Davoskio/8-bit-computer/Computer_PCB.png

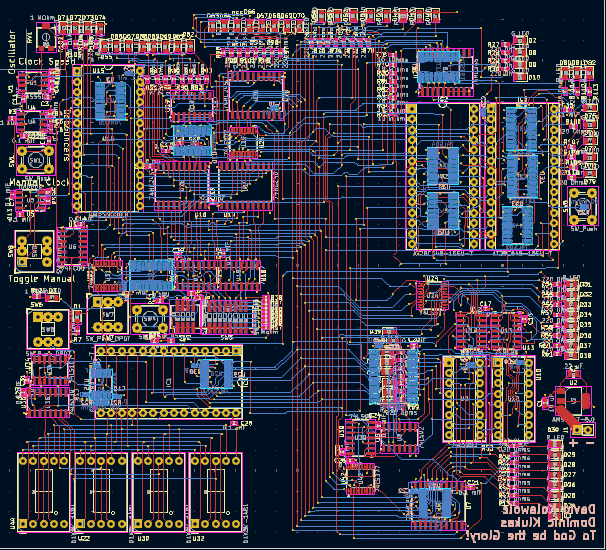
Computer_PCB.png
