Davoskio/8-bit-computer/Computer_schematic.png

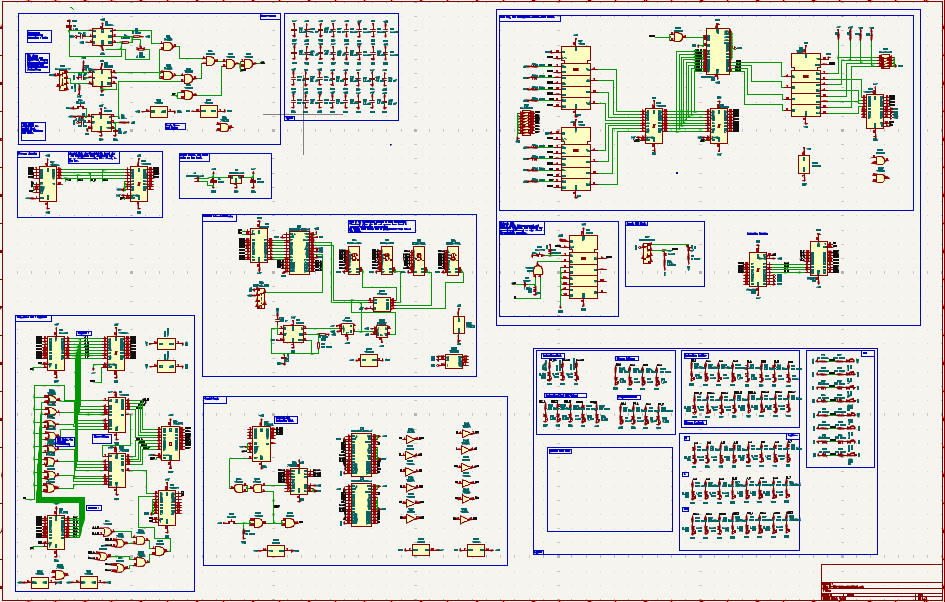
Computer_schematic.png
