Davoskio/8-bit-computer/8-Bit-Computer/8-Bit-Computer.kicad_pcb

## KiCad design 8-Bit-Computer/8-Bit-Computer.kicad_pcb (2024-05-07)

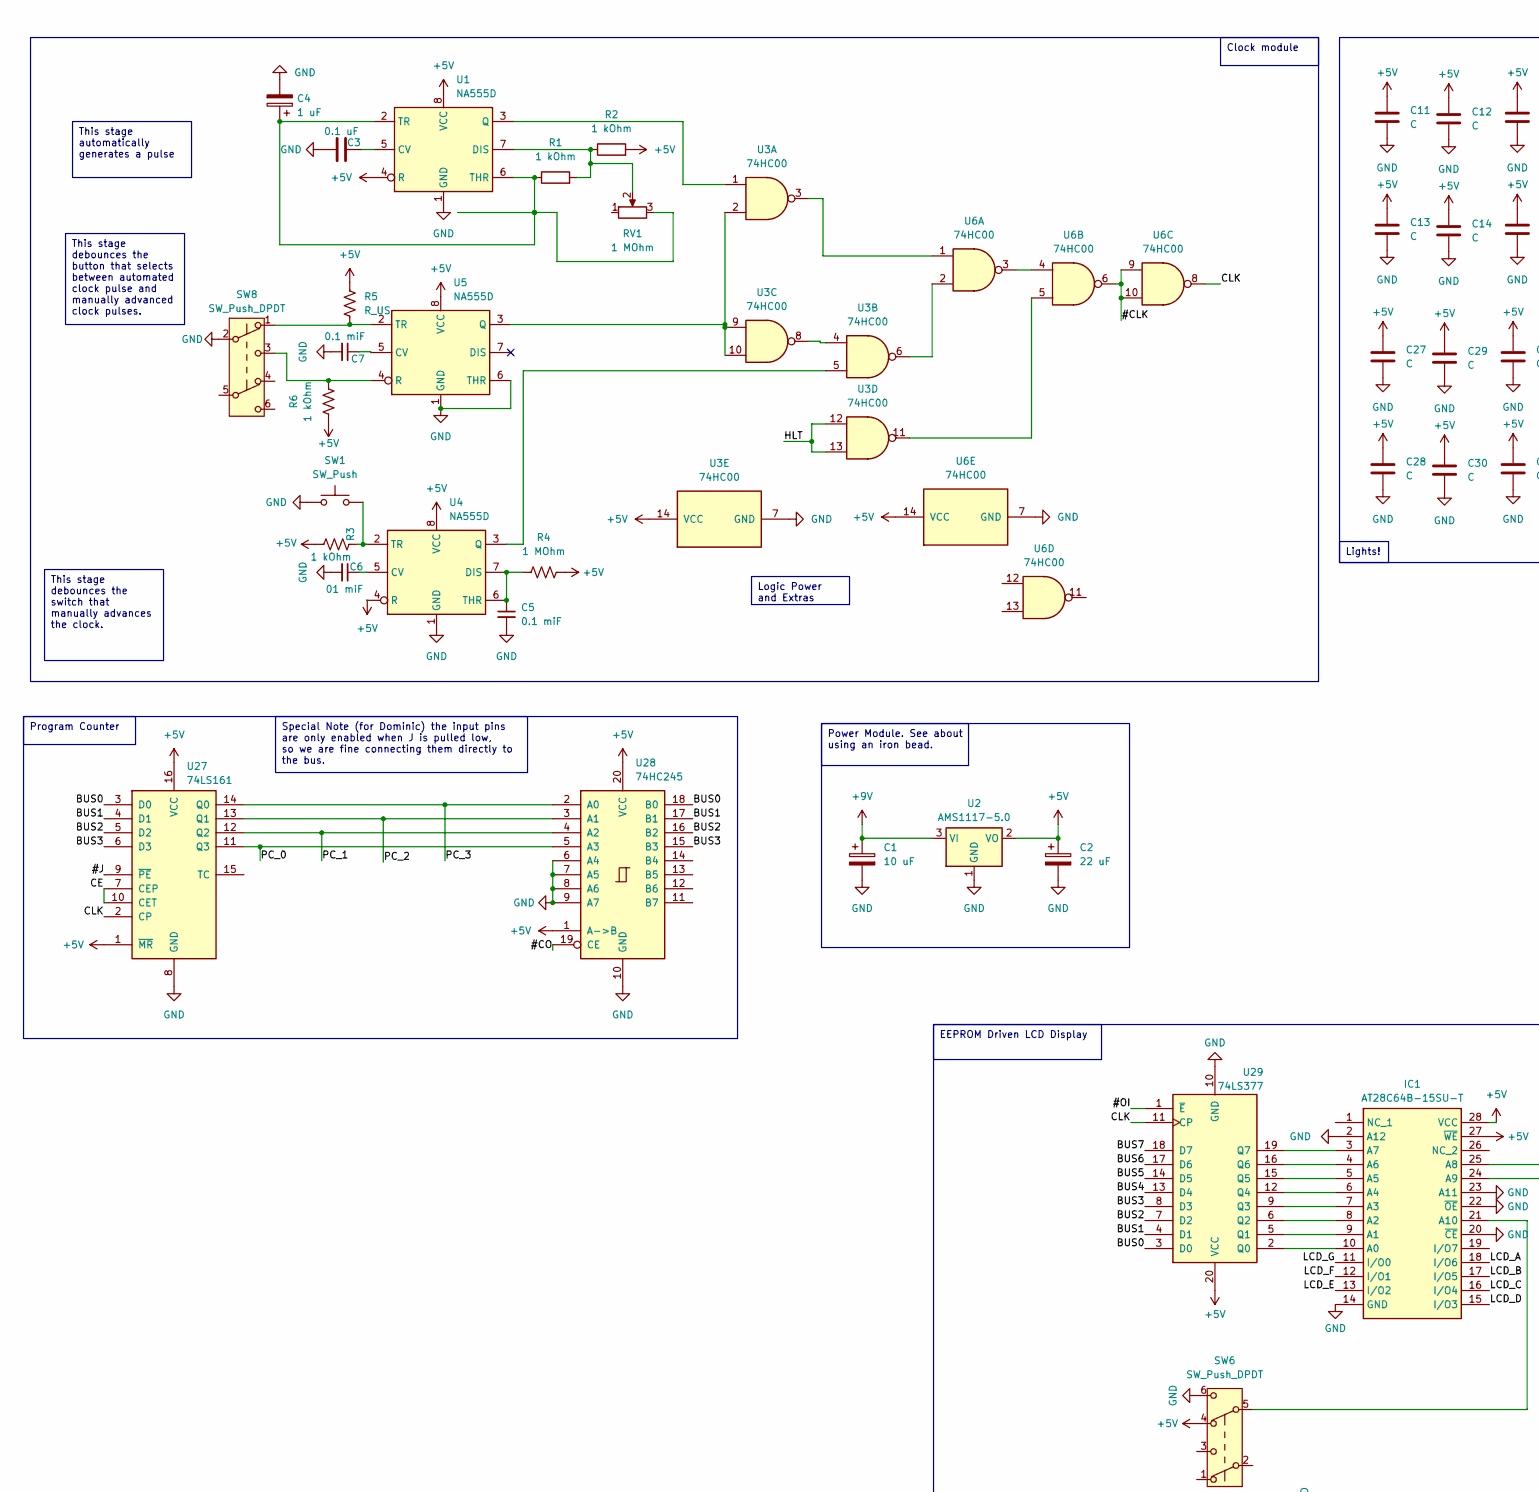
[picture p3: schematic 8-Bit-Computer.kicad_sch, part in row 1, column 1]

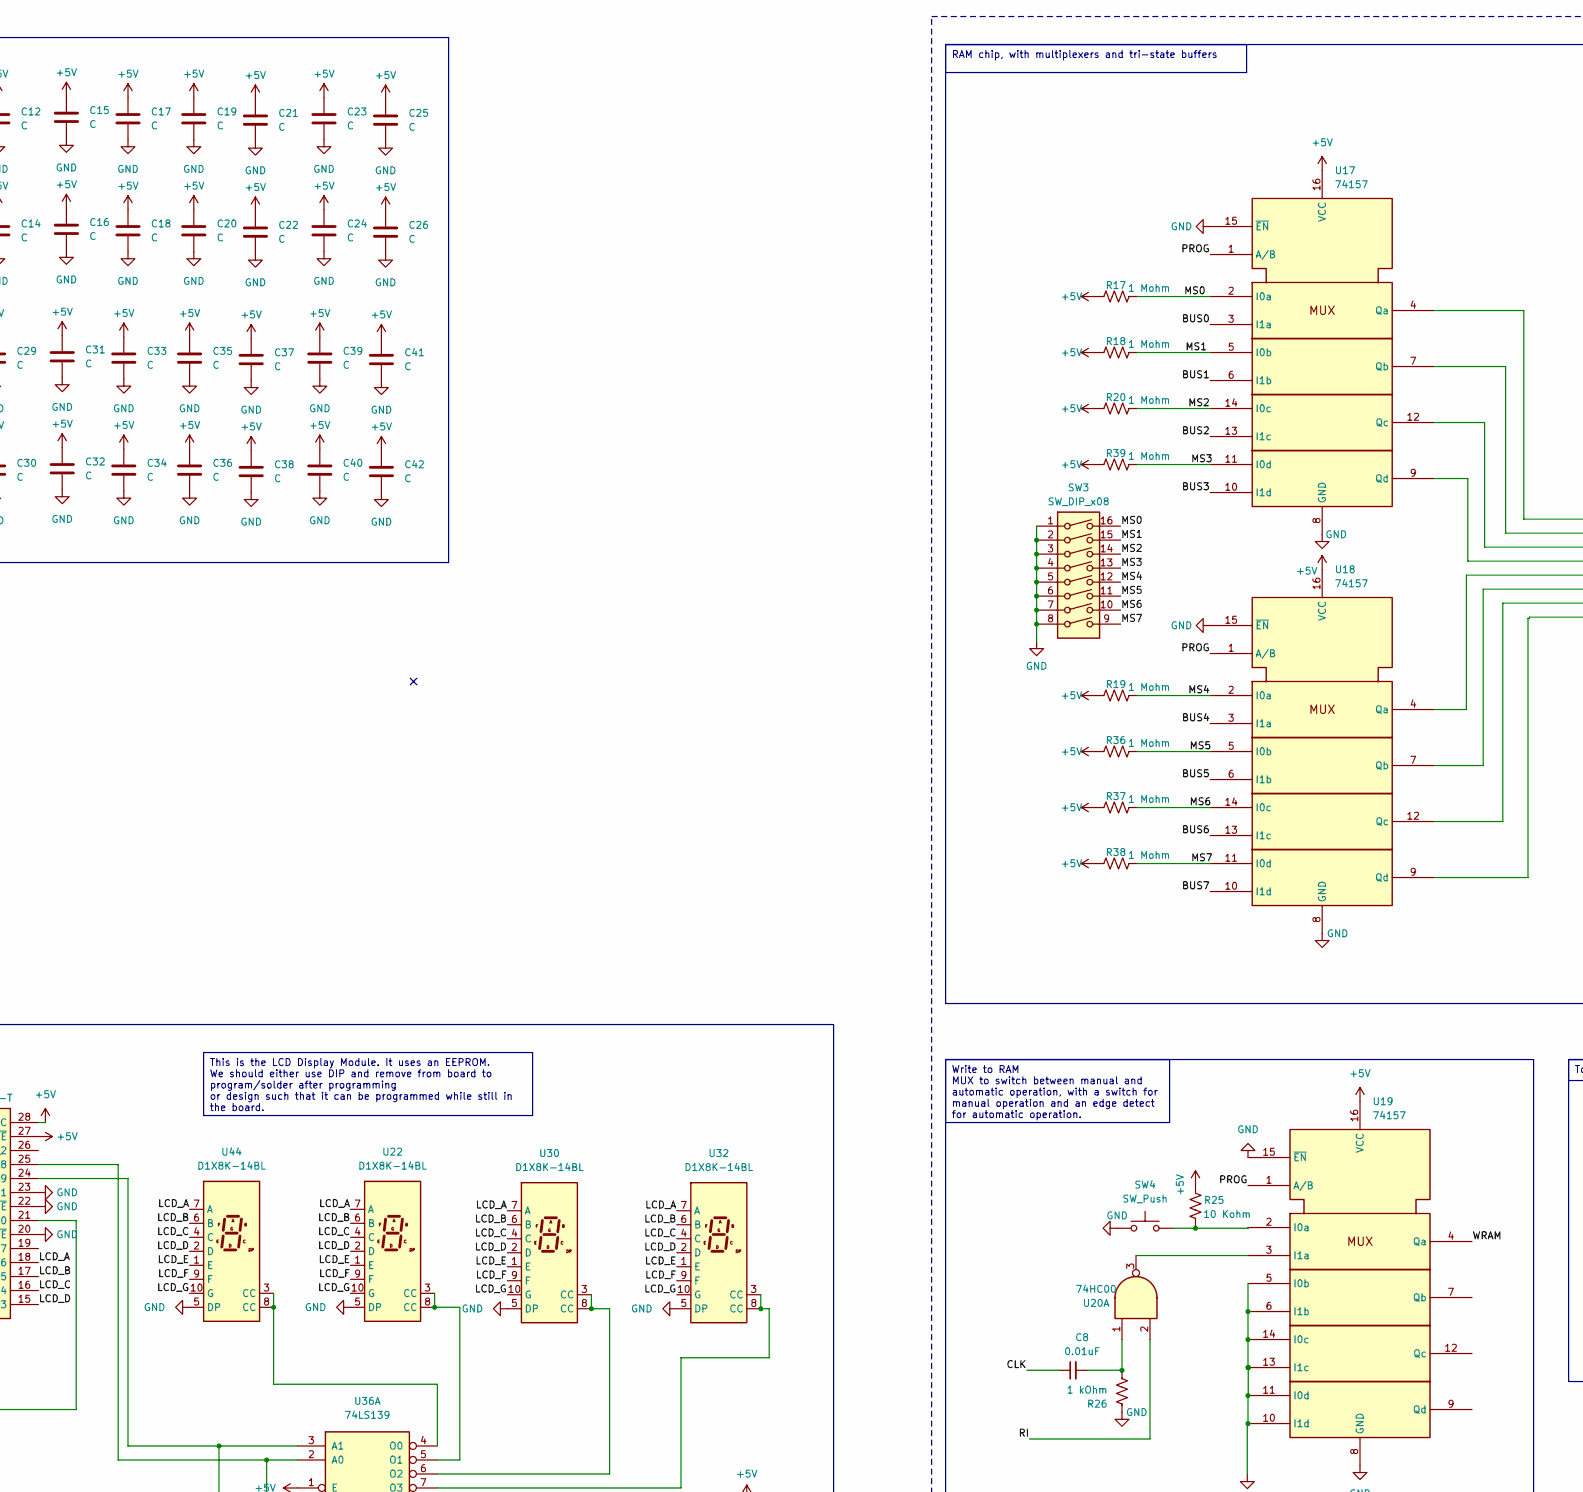
[picture p4: schematic 8-Bit-Computer.kicad_sch, part in row 1, column 2]

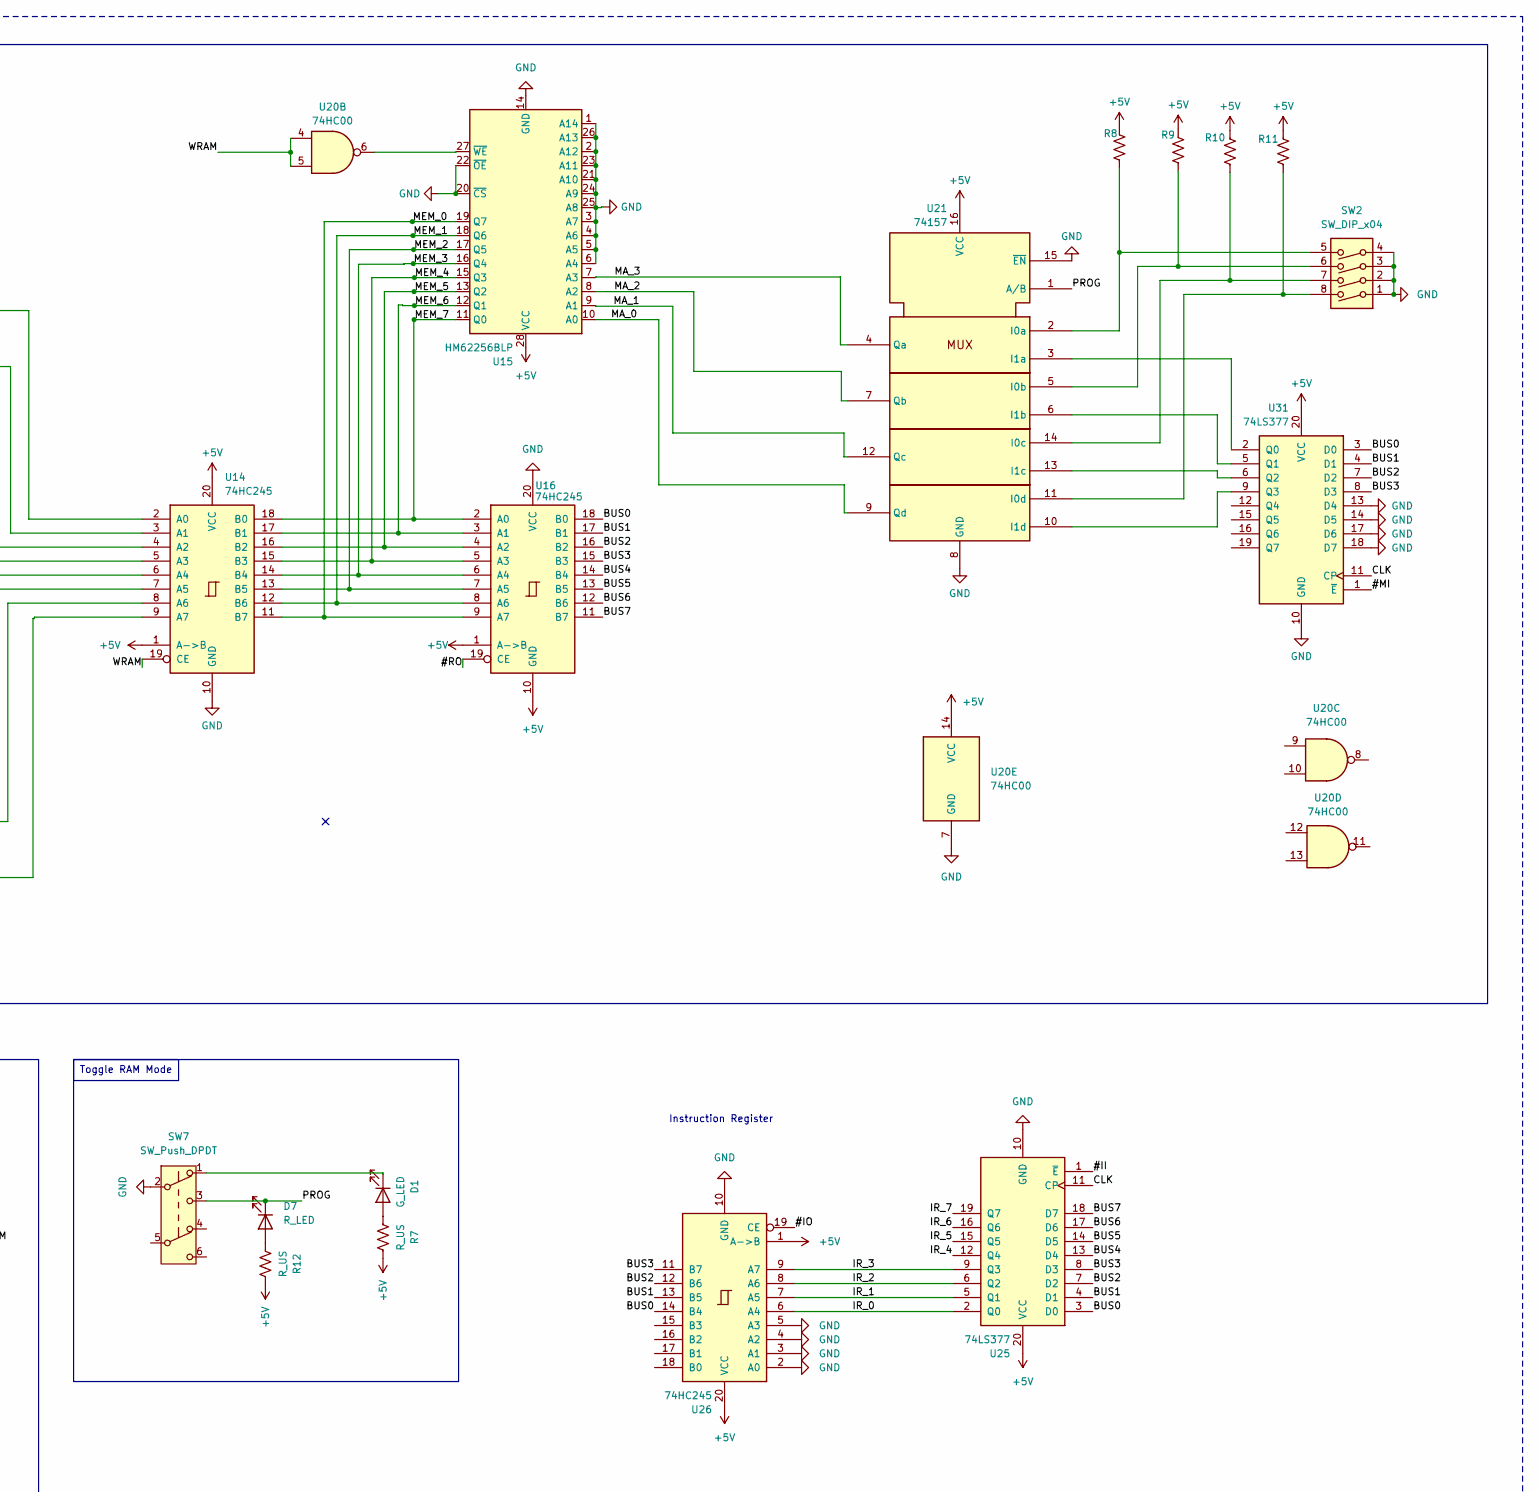
[picture p5: schematic 8-Bit-Computer.kicad_sch, part in row 1, column 3]

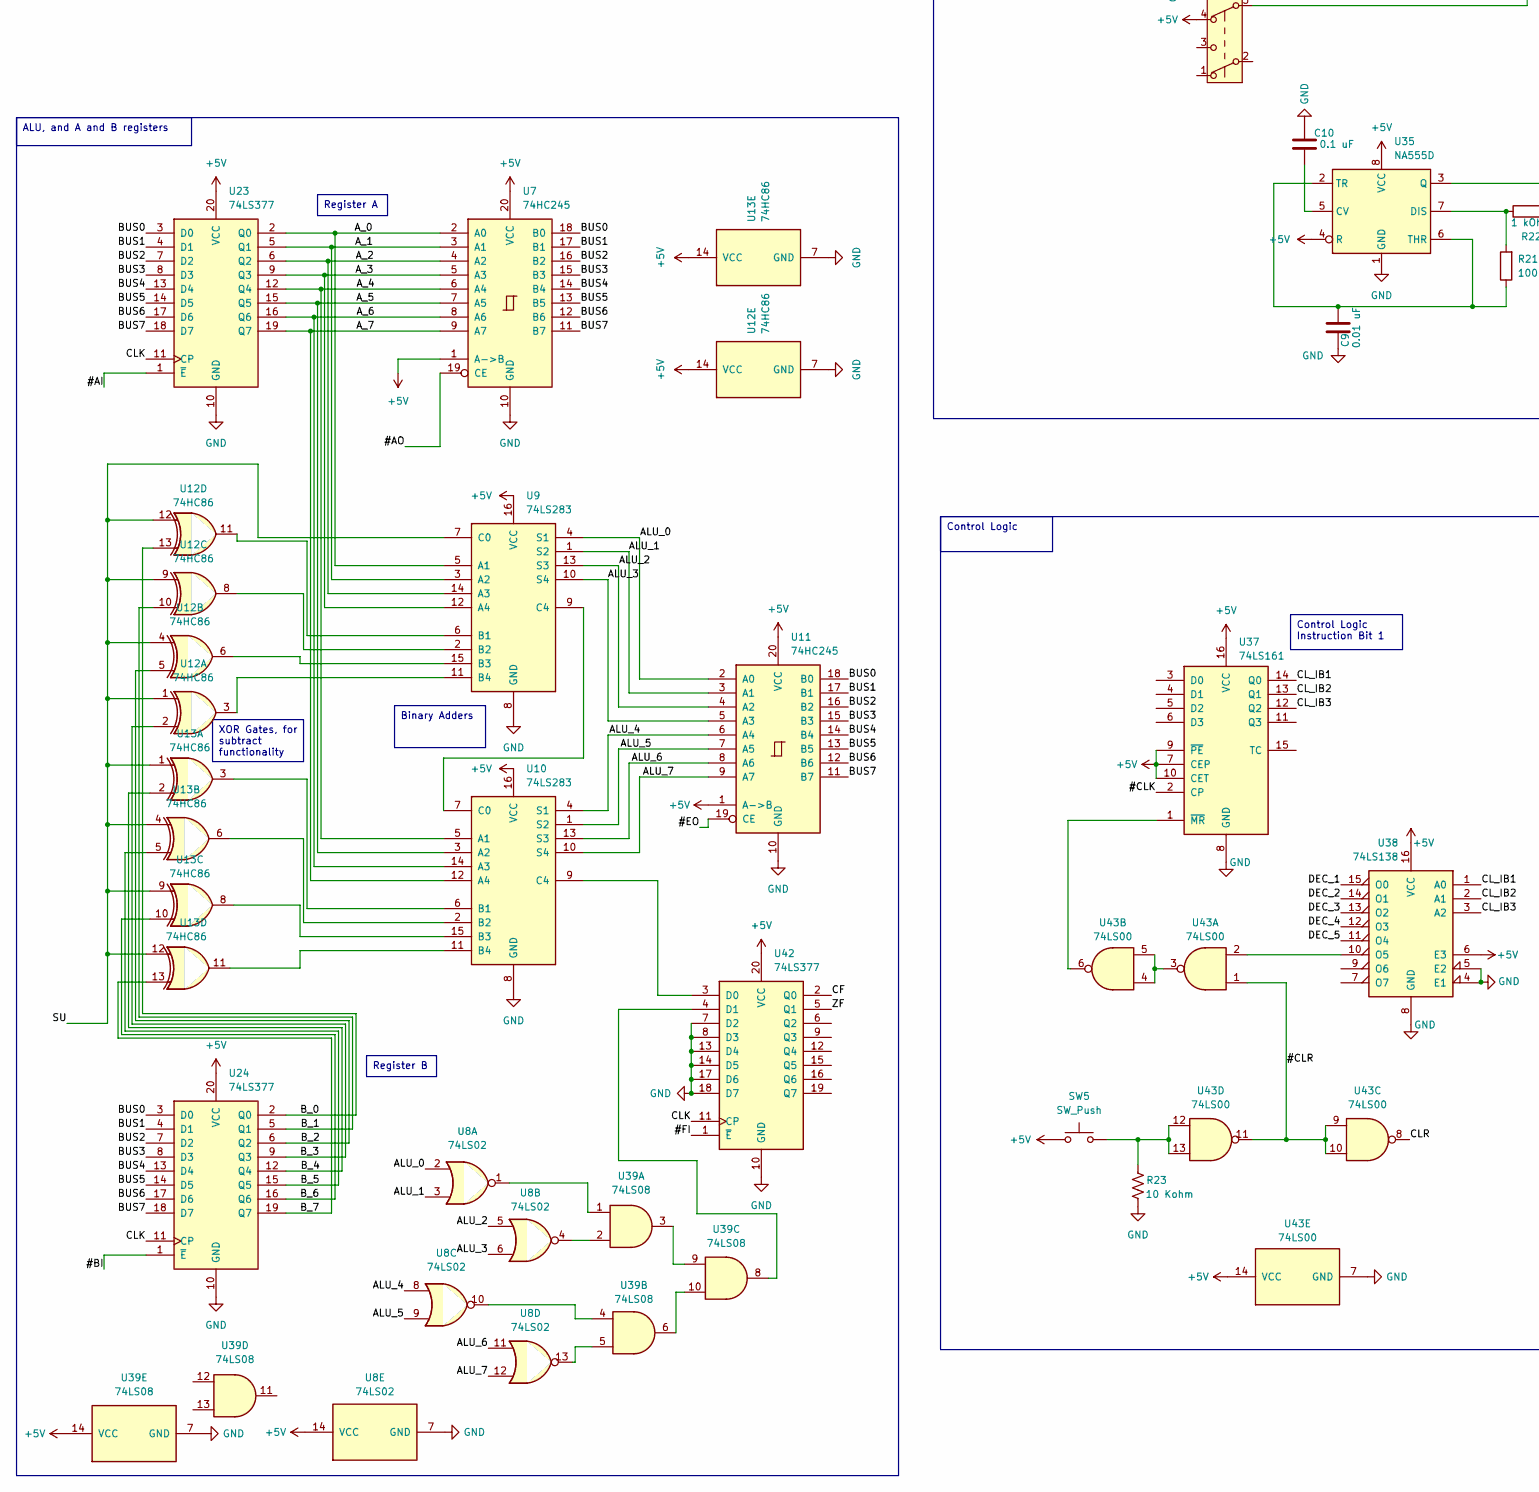
[picture p6: schematic 8-Bit-Computer.kicad_sch, part in row 2, column 1]

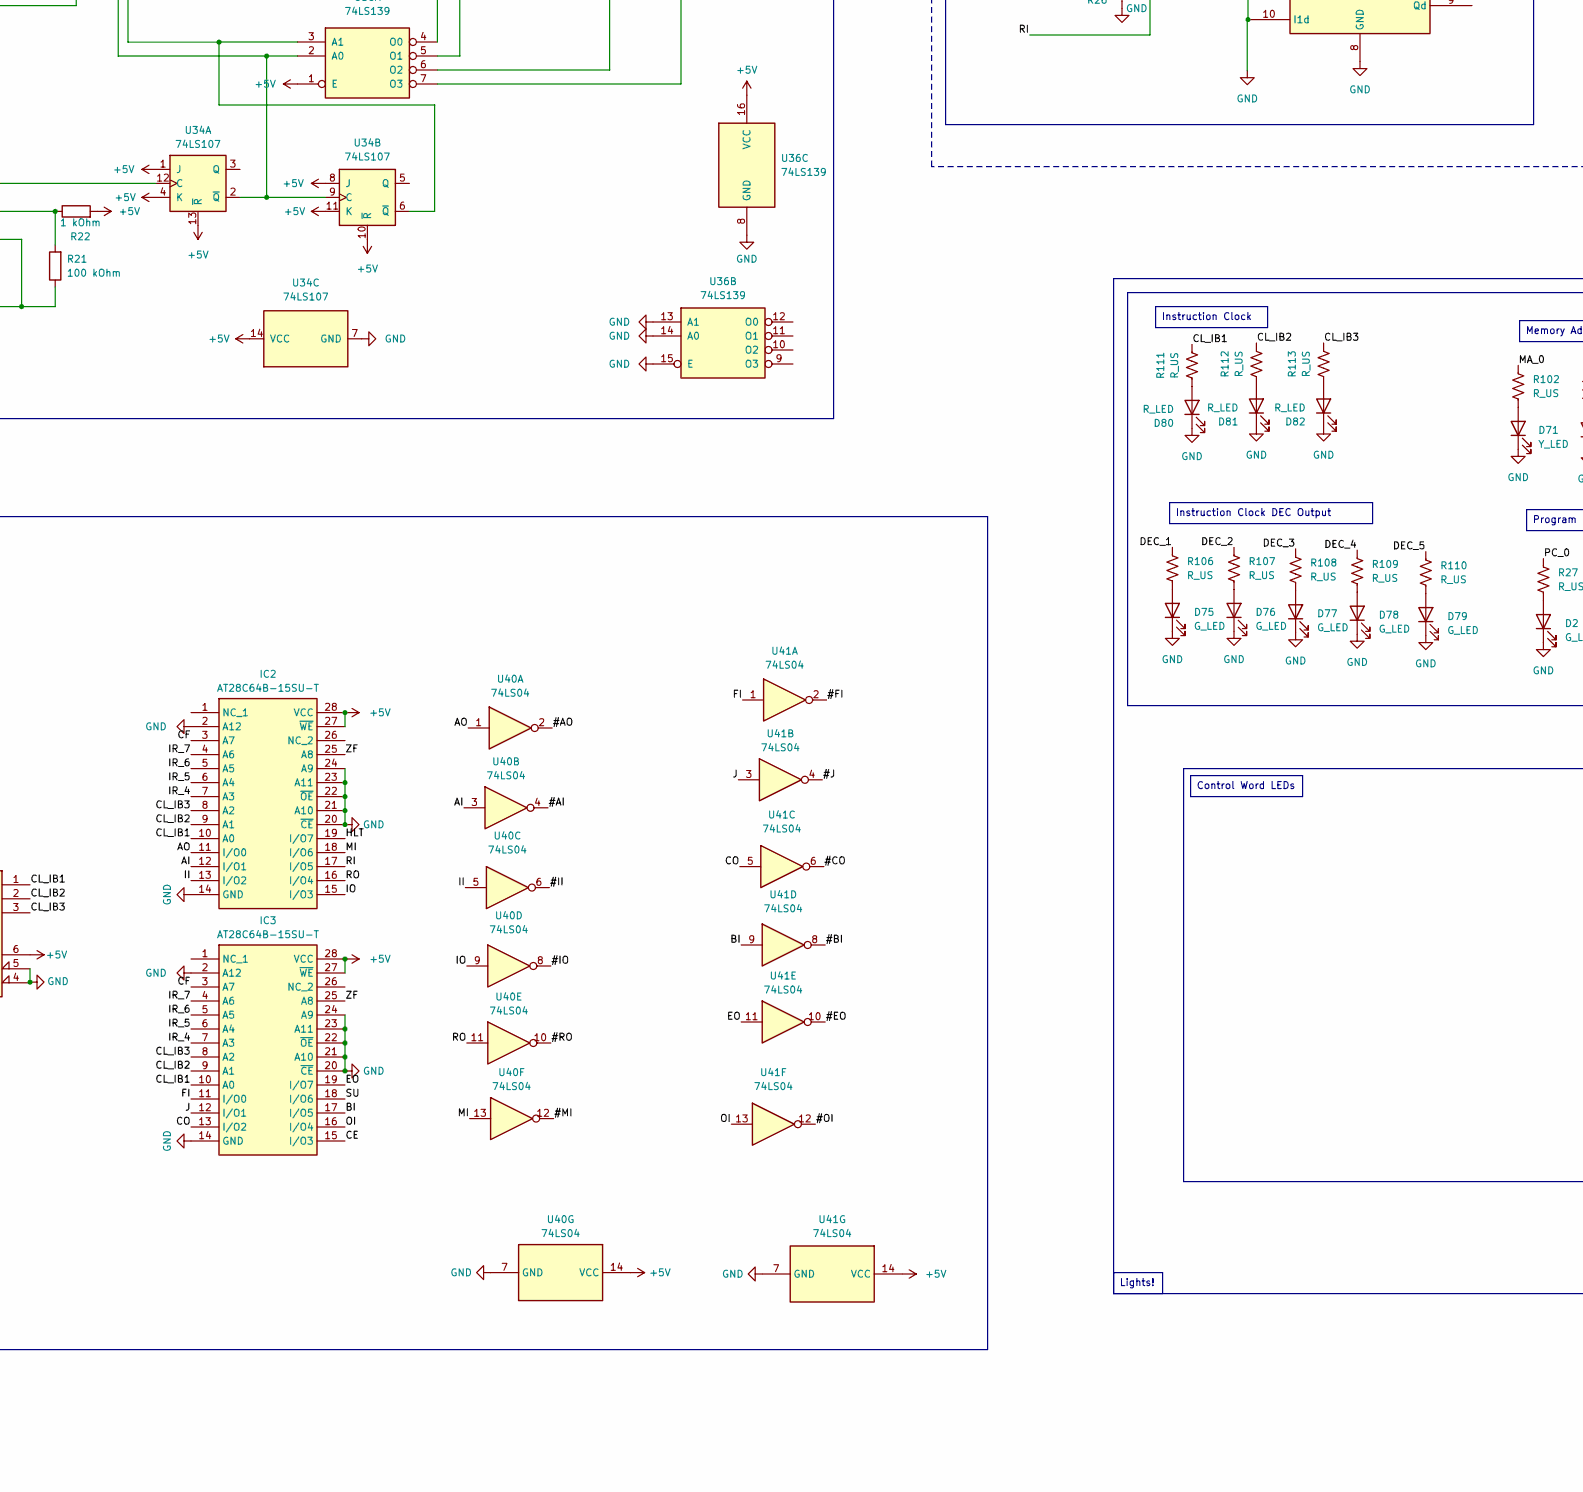
[picture p7: schematic 8-Bit-Computer.kicad_sch, part in row 2, column 2]

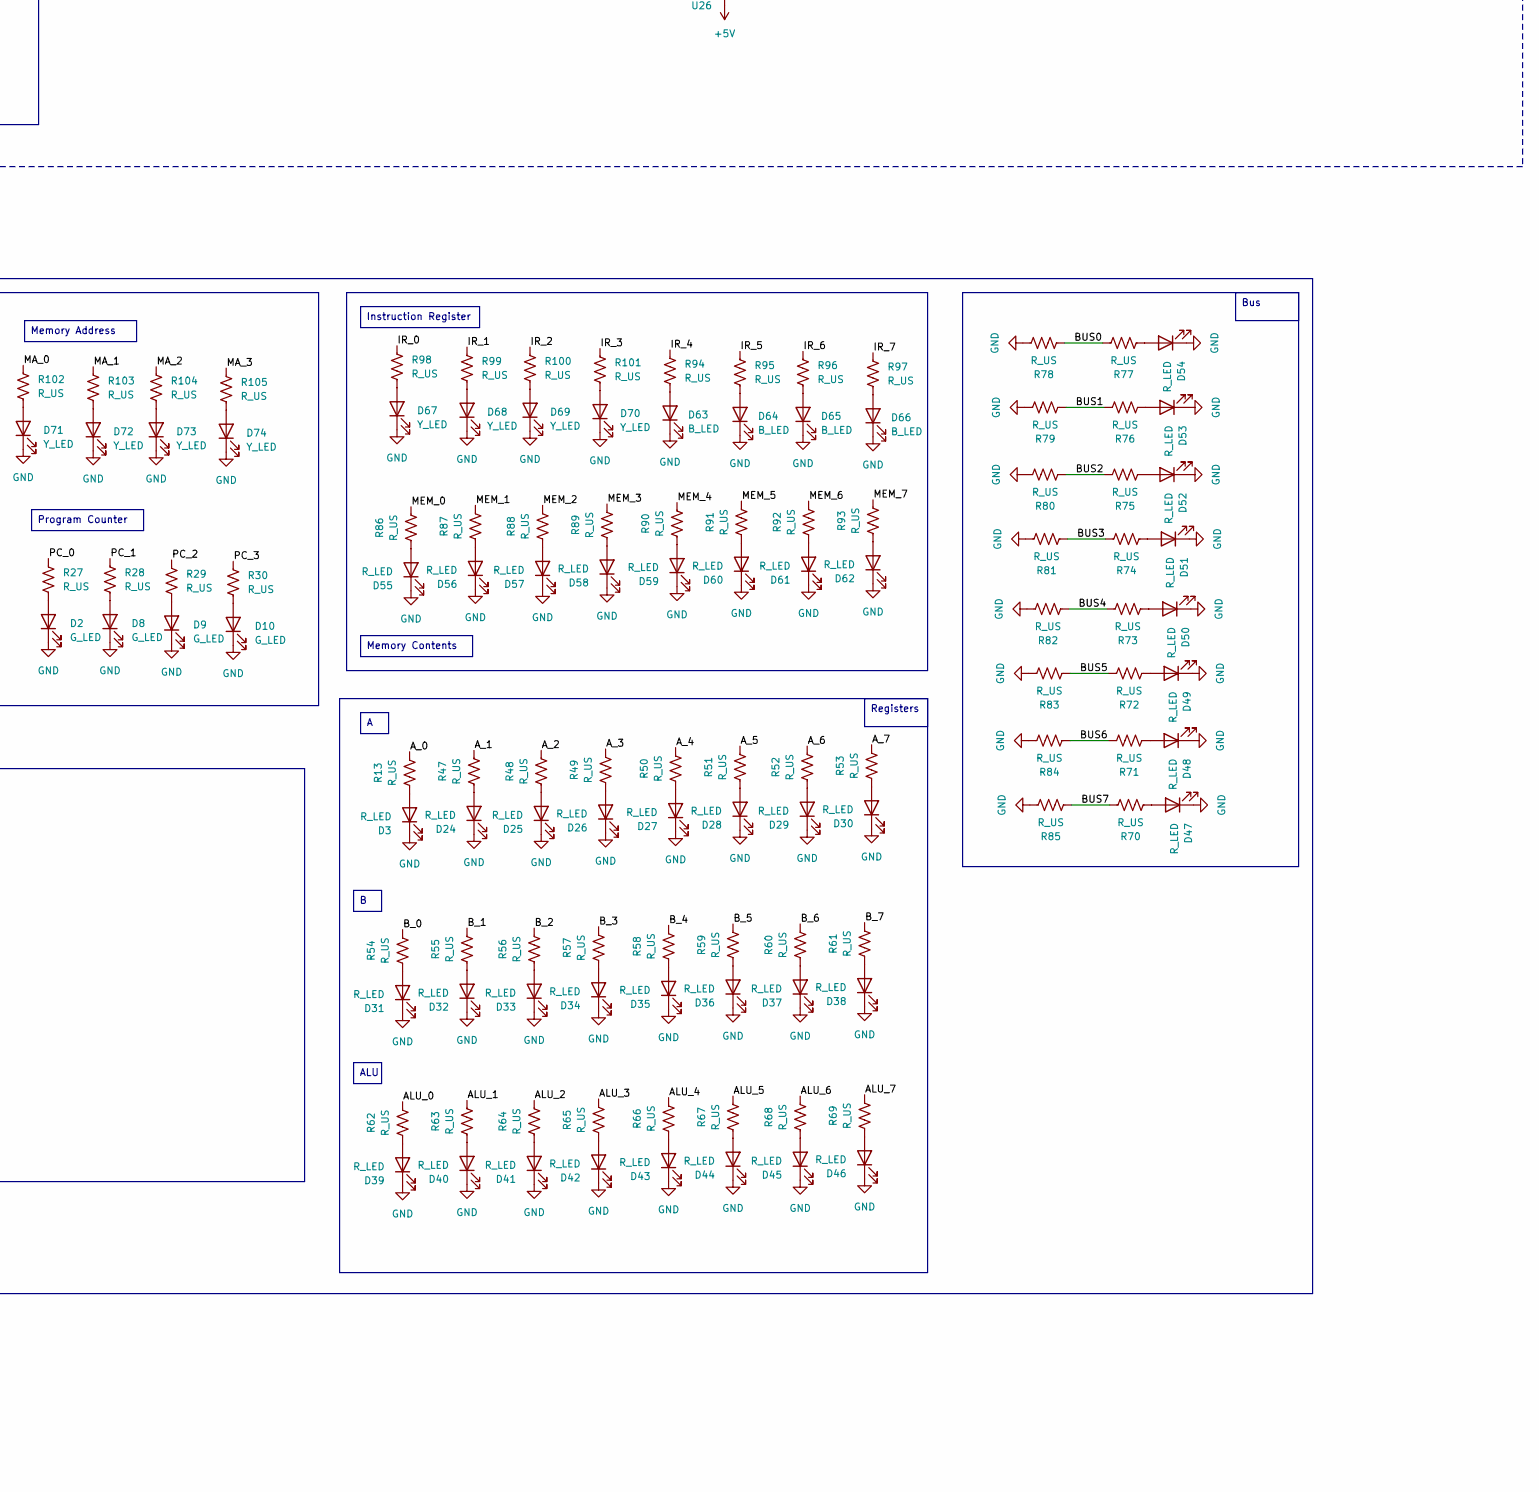
[picture p8: schematic 8-Bit-Computer.kicad_sch, part in row 2, column 3]

Parts:
C1: 10 uF; C_0603_1608Metric
C2: 22 uF; C_0805_2012Metric
C3, C10: 0.1 uF; C_0402_1005Metric
C4: 1 uF; C_0402_1005Metric
C5, C7: 0.1 miF; C_0402_1005Metric
C6: 01 miF; C_0402_1005Metric
C8: 0.01uF; C_0402_1005Metric
C9: 0.01 uF; C_0402_1005Metric
C11, C12, C13, C14, C15, C16, C17, C18, C19, C20, C21, C22, C23, C24, C25, C26, C27, C28, C29, C30, C31, C32, C33, C34, C35, C36, C37, C38, C39, C40, C41, C42: C; C_0402_1005Metric
D1, D2, D8, D9, D10, D75, D76, D77, D78, D79: G_LED; LED_0805_2012Metric
D3, D7, D24, D25, D26, D27, D28, D29, D30, D31, D32, D33, D34, D35, D36, D37, D38, D39, D40, D41, D42, D43, D44, D45, D46, D47, D48, D49, D50, D51, D52, D53, D54, D55, D56, D57, D58, D59, D60, D61, D62, D80, D81, D82: R_LED; LED_0805_2012Metric
D63, D64, D65, D66: B_LED; LED_0805_2012Metric
D67, D68, D69, D70, D71, D72, D73, D74: Y_LED; LED_0805_2012Metric
IC1, IC2, IC3: AT28C64B-15SU-T; DIP-28_W15.24mm_Socket; Mouser Part Number 556-AT28C64B-15SU-T
R1, R2, R3, R6, R22, R26: 1 kOhm; R_0402_1005Metric
R4: 1 MOhm; R_0402_1005Metric
R5, R7, R8, R9, R10, R11, R12, R13, R27, R28, R29, R30, R47, R48, R49, R50, R51, R52, R53, R54, R55, R56, R57, R58, R59, R60, R61, R62, R63, R64, R65, R66, R67, R68, R69, R70, R71, R72, R73, R74, R75, R76, R77, R78, R79, R80, R81, R82, R83, R84, R85, R86, R87, R88, R89, R90, R91, R92, R93, R94, R95, R96, R97, R98, R99, R100, R101, R102, R103, R104, R105, R106, R107, R108, R109, R110, R111, R112, R113: R_US; R_0402_1005Metric
R17, R18, R19, R20, R36, R37, R38, R39: 1 Mohm; R_0402_1005Metric
R21: 100 kOhm; R_0402_1005Metric
R23, R25: 10 Kohm; R_0402_1005Metric
RV1: 1 MOhm; Potentiometer_Bourns_3314G_Vertical
SW1, SW4, SW5: SW_Push; SW_PUSH_6mm
SW2: SW_DIP_x04; SW_DIP_SPSTx04_Slide_KingTek_DSHP04TJ_W5.25mm_P1.27mm_JPin
SW3: SW_DIP_x08; SW_DIP_SPSTx08_Slide_KingTek_DSHP08TJ_W5.25mm_P1.27mm_JPin
SW6, SW7, SW8: SW_Push_DPDT; SW_Push_2P2T_Toggle_CK_PVA2xxH4xxxxxxV2
U1, U4, U5, U35: NA555D; SOP-8_3.9x4.9mm_P1.27mm
U2: AMS1117-5.0; SOT-223-3_TabPin2
U3, U6, U20: 74HC00; SOIC-14_3.9x8.7mm_P1.27mm
U7, U11, U14, U16, U26, U28: 74HC245; SOIC-20W_7.5x12.8mm_P1.27mm
U8: 74LS02; SOIC-14_3.9x8.7mm_P1.27mm
U9, U10: 74LS283; DIP-16_W7.62mm_Socket
U12, U13: 74HC86; SOIC-14_3.9x8.7mm_P1.27mm
U15: HM62256BLP; DIP-28_W15.24mm
U17, U18, U19, U21: 74157; SOIC-16_3.9x9.9mm_P1.27mm
U22, U30, U32, U44: D1X8K-14BL; D1X8K
U23, U24, U25, U29, U31, U42: 74LS377; TSSOP-20_4.4x6.5mm_P0.65mm
U27, U37: 74LS161; SOIC-16_3.9x9.9mm_P1.27mm
U34: 74LS107; SOIC-14_3.9x8.7mm_P1.27mm
U36: 74LS139; SOIC-16_3.9x9.9mm_P1.27mm
U38: 74LS138; SOIC-16_3.9x9.9mm_P1.27mm
U39: 74LS08; SOIC-14_3.9x8.7mm_P1.27mm
U40, U41: 74LS04; SOIC-14_3.9x8.7mm_P1.27mm
U43: 74LS00; SOIC-14_3.9x8.7mm_P1.27mm

Connections:
+5V: C2.1, C11.1, C12.1, C13.1, C14.1, C15.1, C16.1, C17.1, C18.1, C19.1, C20.1, C21.1, C22.1, C23.1, C24.1, C25.1, C26.1, C27.1, C28.1, C29.1, C30.1, C31.1, C32.1, C33.1, C34.1, C35.1, C36.1, C37.1, C38.1, C39.1, C40.1, C41.1, C42.1, IC1.27 (~WE), IC1.28 (VCC), IC2.27 (~WE), IC2.28 (VCC), IC3.27 (~WE), IC3.28 (VCC), R2.2, R3.1, R4.2, R5.1, R6.1, R7.2, R8.2, R9.2, R10.2, R11.2, R12.2, R17.2, R18.2, R19.2, R20.2, R22.2, R25.2, R36.2, R37.2, R38.2, R39.2, SW5.1, SW6.4 (A), U1.4 (R), U1.8 (VCC), U2.2 (VO), U3.14 (VCC), U4.4 (R), U4.8 (VCC), U5.8 (VCC), U6.14 (VCC), U7.1 (A->B), U7.20 (VCC), U8.14 (VCC), U9.16 (VCC), U10.16 (VCC), U11.1 (A->B), U11.20 (VCC), U12.14 (VCC), U13.14 (VCC), U14.1 (A->B), U14.20 (VCC), U15.28 (VCC), U16.1 (A->B), U16.10 (GND), U17.16 (VCC), U18.16 (VCC), U19.16 (VCC), U20.14 (VCC), U21.16 (VCC), U23.20 (VCC), U24.20 (VCC), U25.20 (VCC), U26.1 (A->B), U26.20 (VCC), U27.1 (~MR), U27.16 (VCC), U28.1 (A->B), U28.20 (VCC), U29.20 (VCC), U31.20 (VCC), U34.1 (J), U34.4 (K), U34.8 (J), U34.10 (~R), U34.11 (K), U34.13 (~R), U34.14 (VCC), U35.4 (R), U35.8 (VCC), U36.1 (E), U36.16 (VCC), U37.7 (CEP), U37.9 (~PE), U37.10 (CET), U37.16 (VCC), U38.6 (E3), U38.16 (VCC), U39.14 (VCC), U40.14 (VCC), U41.14 (VCC), U42.20 (VCC), U43.14 (VCC)
+9V: C1.1, U2.3 (VI)
/#AI: U23.1 (~E), U40.4
/#AO: U7.19 (CE), U40.2
/#BI: U24.1 (~E), U41.8
/#CLK: U6.6, U6.9, U6.10, U37.2 (CP)
/#CLR: U43.1, U43.9, U43.10, U43.11
/#CO: U28.19 (CE), U41.6
/#EO: U11.19 (CE), U41.10
/#FI: U41.2, U42.1 (~E)
/#II: U25.1 (~E), U40.6
/#IO: U26.19 (CE), U40.8
/#J: U27.9 (~PE), U41.4
/#MI: U31.1 (~E), U40.12
/#OI: U29.1 (~E), U41.12
/#RO: U16.19 (CE), U40.10
/AI: IC2.12 (I/O1), U40.3
/ALU_0: R62.2, U8.2, U9.4 (S1), U11.2 (A0)
/ALU_1: R63.2, U8.3, U9.1 (S2), U11.3 (A1)
/ALU_2: R64.2, U8.5, U9.13 (S3), U11.4 (A2)
/ALU_3: R65.2, U8.6, U9.10 (S4), U11.5 (A3)
/ALU_4: R66.2, U8.8, U10.4 (S1), U11.6 (A4)
/ALU_5: R67.2, U8.9, U10.1 (S2), U11.7 (A5)
/ALU_6: R68.2, U8.11, U10.13 (S3), U11.8 (A6)
/ALU_7: R69.2, U8.12, U10.10 (S4), U11.9 (A7)
/AO: IC2.11 (I/O0), U40.1
/A_0: R13.2, U7.2 (A0), U9.5 (A1), U23.2 (Q0)
/A_1: R47.2, U7.3 (A1), U9.3 (A2), U23.5 (Q1)
/A_2: R48.2, U7.4 (A2), U9.14 (A3), U23.6 (Q2)
/A_3: R49.2, U7.5 (A3), U9.12 (A4), U23.9 (Q3)
/A_4: R50.2, U7.6 (A4), U10.5 (A1), U23.12 (Q4)
/A_5: R51.2, U7.7 (A5), U10.3 (A2), U23.15 (Q5)
/A_6: R52.2, U7.8 (A6), U10.14 (A3), U23.16 (Q6)
/A_7: R53.2, U7.9 (A7), U10.12 (A4), U23.19 (Q7)
/BI: IC3.17 (I/O5), U41.9
/BUS0: R77.2, R78.1, U7.18 (B0), U11.18 (B0), U16.18 (B0), U17.3 (I1a), U23.3 (D0), U24.3 (D0), U25.3 (D0), U26.14 (B4), U27.3 (D0), U28.18 (B0), U29.3 (D0), U31.3 (D0)
/BUS1: R76.2, R79.1, U7.17 (B1), U11.17 (B1), U16.17 (B1), U17.6 (I1b), U23.4 (D1), U24.4 (D1), U25.4 (D1), U26.13 (B5), U27.4 (D1), U28.17 (B1), U29.4 (D1), U31.4 (D1)
/BUS2: R75.2, R80.1, U7.16 (B2), U11.16 (B2), U16.16 (B2), U17.13 (I1c), U23.7 (D2), U24.7 (D2), U25.7 (D2), U26.12 (B6), U27.5 (D2), U28.16 (B2), U29.7 (D2), U31.7 (D2)
/BUS3: R74.2, R81.1, U7.15 (B3), U11.15 (B3), U16.15 (B3), U17.10 (I1d), U23.8 (D3), U24.8 (D3), U25.8 (D3), U26.11 (B7), U27.6 (D3), U28.15 (B3), U29.8 (D3), U31.8 (D3)
/BUS4: R73.2, R82.1, U7.14 (B4), U11.14 (B4), U16.14 (B4), U18.3 (I1a), U23.13 (D4), U24.13 (D4), U25.13 (D4), U29.13 (D4)
/BUS5: R72.2, R83.1, U7.13 (B5), U11.13 (B5), U16.13 (B5), U18.6 (I1b), U23.14 (D5), U24.14 (D5), U25.14 (D5), U29.14 (D5)
/BUS6: R71.2, R84.1, U7.12 (B6), U11.12 (B6), U16.12 (B6), U18.13 (I1c), U23.17 (D6), U24.17 (D6), U25.17 (D6), U29.17 (D6)
/BUS7: R70.2, R85.1, U7.11 (B7), U11.11 (B7), U16.11 (B7), U18.10 (I1d), U23.18 (D7), U24.18 (D7), U25.18 (D7), U29.18 (D7)
/B_0: R54.2, U12.13, U24.2 (Q0)
/B_1: R55.2, U12.10, U24.5 (Q1)
/B_2: R56.2, U12.5, U24.6 (Q2)
/B_3: R57.2, U12.2, U24.9 (Q3)
/B_4: R58.2, U13.2, U24.12 (Q4)
/B_5: R59.2, U13.5, U24.15 (Q5)
/B_6: R60.2, U13.10, U24.16 (Q6)
/B_7: R61.2, U13.13, U24.19 (Q7)
/CE: IC3.15 (I/O3), U27.7 (CEP), U27.10 (CET)
/CF: IC2.3 (A7), IC3.3 (A7), U42.2 (Q0)
/CLK: C8.1, U6.8, U23.11 (CP), U24.11 (CP), U25.11 (CP), U27.2 (CP), U29.11 (CP), U31.11 (CP), U42.11 (CP)
/CLR: U43.8
/CL_IB1: IC2.10 (A0), IC3.10 (A0), R111.2, U37.14 (Q0), U38.1 (A0)
/CL_IB2: IC2.9 (A1), IC3.9 (A1), R112.2, U37.13 (Q1), U38.2 (A1)
/CL_IB3: IC2.8 (A2), IC3.8 (A2), R113.2, U37.12 (Q2), U38.3 (A2)
/CO: IC3.13 (I/O2), U41.5
/DEC_1: R106.1, U38.15 (O0)
/DEC_2: R107.1, U38.14 (O1)
/DEC_3: R108.1, U38.13 (O2)
/DEC_4: R109.1, U38.12 (O3)
/DEC_5: R110.1, U38.11 (O4)
/EO: IC3.19 (I/O7), U41.11
/FI: IC3.11 (I/O0), U41.1
/HLT: IC2.19 (I/O7), U3.12, U3.13
/II: IC2.13 (I/O2), U40.5
/IO: IC2.15 (I/O3), U40.9
/IR_0: R98.1, U25.2 (Q0), U26.6 (A4)
/IR_1: R99.1, U25.5 (Q1), U26.7 (A5)
/IR_2: R100.1, U25.6 (Q2), U26.8 (A6)
/IR_3: R101.1, U25.9 (Q3), U26.9 (A7)
/IR_4: IC2.7 (A3), IC3.7 (A3), R94.1, U25.12 (Q4)
/IR_5: IC2.6 (A4), IC3.6 (A4), R95.1, U25.15 (Q5)
/IR_6: IC2.5 (A5), IC3.5 (A5), R96.1, U25.16 (Q6)
/IR_7: IC2.4 (A6), IC3.4 (A6), R97.1, U25.19 (Q7)
/J: IC3.12 (I/O1), U41.3
/LCD_A: IC1.18 (I/O6), U22.7 (A), U30.7 (A), U32.7 (A), U44.7 (A)
/LCD_B: IC1.17 (I/O5), U22.6 (B), U30.6 (B), U32.6 (B), U44.6 (B)
/LCD_C: IC1.16 (I/O4), U22.4 (C), U30.4 (C), U32.4 (C), U44.4 (C)
/LCD_D: IC1.15 (I/O3), U22.2 (D), U30.2 (D), U32.2 (D), U44.2 (D)
/LCD_E: IC1.13 (I/O2), U22.1 (E), U30.1 (E), U32.1 (E), U44.1 (E)
/LCD_F: IC1.12 (I/O1), U22.9 (F), U30.9 (F), U32.9 (F), U44.9 (F)
/LCD_G: IC1.11 (I/O0), U22.10 (G), U30.10 (G), U32.10 (G), U44.10 (G)
/MA_0: R102.1, U15.10 (A0), U21.9 (Qd)
/MA_1: R103.1, U15.9 (A1), U21.12 (Qc)
/MA_2: R104.1, U15.8 (A2), U21.7 (Qb)
/MA_3: R105.1, U15.7 (A3), U21.4 (Qa)
/MEM_0: R86.2, U14.11 (B7), U15.19 (Q7), U16.9 (A7)
/MEM_1: R87.2, U14.12 (B6), U15.18 (Q6), U16.8 (A6)
/MEM_2: R88.2, U14.13 (B5), U15.17 (Q5), U16.7 (A5)
/MEM_3: R89.2, U14.14 (B4), U15.16 (Q4), U16.6 (A4)
/MEM_4: R90.2, U14.15 (B3), U15.15 (Q3), U16.5 (A3)
/MEM_5: R91.2, U14.16 (B2), U15.13 (Q2), U16.4 (A2)
/MEM_6: R92.2, U14.17 (B1), U15.12 (Q1), U16.3 (A1)
/MEM_7: R93.2, U14.18 (B0), U15.11 (Q0), U16.2 (A0)
/MI: IC2.18 (I/O6), U40.13
/MS0: R17.1, SW3.16, U17.2 (I0a)
/MS1: R18.1, SW3.15, U17.5 (I0b)
/MS2: R20.1, SW3.14, U17.14 (I0c)
/MS3: R39.1, SW3.13, U17.11 (I0d)
/MS4: R19.1, SW3.12, U18.2 (I0a)
/MS5: R36.1, SW3.11, U18.5 (I0b)
/MS6: R37.1, SW3.10, U18.14 (I0c)
/MS7: R38.1, SW3.9, U18.11 (I0d)
/OI: IC3.16 (I/O4), U41.13
/PC_0: R27.1, U27.11 (Q3), U28.5 (A3)
/PC_1: R28.1, U27.12 (Q2), U28.4 (A2)
/PC_2: R29.1, U27.13 (Q1), U28.3 (A1)
/PC_3: R30.1, U27.14 (Q0), U28.2 (A0)
/PROG: D7.1 (K), SW7.3 (C), U17.1 (A/B), U18.1 (A/B), U19.1 (A/B), U21.1 (A/B)
/RO: IC2.16 (I/O4), U40.11
/SU: IC3.18 (I/O6), U9.7 (C0), U12.1, U12.4, U12.9, U12.12, U13.1, U13.4, U13.9, U13.12
/ZF: IC2.25 (A8), IC3.25 (A8), U42.5 (Q1)
GND: C1.2, C2.2, C3.1, C4.2, C5.2, C6.2, C7.2, C9.2, C10.1, C11.2, C12.2, C13.2, C14.2, C15.2, C16.2, C17.2, C18.2, C19.2, C20.2, C21.2, C22.2, C23.2, C24.2, C25.2, C26.2, C27.2, C28.2, C29.2, C30.2, C31.2, C32.2, C33.2, C34.2, C35.2, C36.2, C37.2, C38.2, C39.2, C40.2, C41.2, C42.2, D2.1 (K), D3.1 (K), D8.1 (K), D9.1 (K), D10.1 (K), D24.1 (K), D25.1 (K), D26.1 (K), D27.1 (K), D28.1 (K), D29.1 (K), D30.1 (K), D31.1 (K), D32.1 (K), D33.1 (K), D34.1 (K), D35.1 (K), D36.1 (K), D37.1 (K), D38.1 (K), D39.1 (K), D40.1 (K), D41.1 (K), D42.1 (K), D43.1 (K), D44.1 (K), D45.1 (K), D46.1 (K), D47.1 (K), D48.1 (K), D49.1 (K), D50.1 (K), D51.1 (K), D52.1 (K), D53.1 (K), D54.1 (K), D55.1 (K), D56.1 (K), D57.1 (K), D58.1 (K), D59.1 (K), D60.1 (K), D61.1 (K), D62.1 (K), D63.1 (K), D64.1 (K), D65.1 (K), D66.1 (K), D67.1 (K), D68.1 (K), D69.1 (K), D70.1 (K), D71.1 (K), D72.1 (K), D73.1 (K), D74.1 (K), D75.1 (K), D76.1 (K), D77.1 (K), D78.1 (K), D79.1 (K), D80.1 (K), D81.1 (K), D82.1 (K), IC1.2 (A12), IC1.14 (GND), IC1.20 (~CE), IC1.22 (~OE), IC1.23 (A11), IC2.2 (A12), IC2.14 (GND), IC2.20 (~CE), IC2.21 (A10), IC2.22 (~OE), IC2.23 (A11), IC2.24 (A9), IC3.2 (A12), IC3.14 (GND), IC3.20 (~CE), IC3.21 (A10), IC3.22 (~OE), IC3.23 (A11), IC3.24 (A9), R23.1, R26.2, R78.2, R79.2, R80.2, R81.2, R82.2, R83.2, R84.2, R85.2, SW1.1, SW2.1, SW2.2, SW2.3, SW2.4, SW3.1, SW3.2, SW3.3, SW3.4, SW3.5, SW3.6, SW3.7, SW3.8, SW4.1, SW6.6 (C), SW7.2 (B), SW8.2 (B), U1.1 (GND), U2.1 (GND), U3.7 (GND), U4.1 (GND), U5.1 (GND), U5.6 (THR), U6.7 (GND), U7.10 (GND), U8.7 (GND), U9.8 (GND), U10.8 (GND), U11.10 (GND), U12.7 (GND), U13.7 (GND), U14.10 (GND), U15.1 (A14), U15.2 (A12), U15.3 (A7), U15.4 (A6), U15.5 (A5), U15.6 (A4), U15.14 (GND), U15.20 (~CS), U15.21 (A10), U15.22 (~OE), U15.23 (A11), U15.24 (A9), U15.25 (A8), U15.26 (A13), U16.20 (VCC), U17.8 (GND), U17.15 (~EN), U18.8 (GND), U18.15 (~EN), U19.5 (I0b), U19.6 (I1b), U19.8 (GND), U19.10 (I1d), U19.11 (I0d), U19.13 (I1c), U19.14 (I0c), U19.15 (~EN), U20.7 (GND), U21.8 (GND), U21.15 (~EN), U22.5 (DP), U23.10 (GND), U24.10 (GND), U25.10 (GND), U26.2 (A0), U26.3 (A1), U26.4 (A2), U26.5 (A3), U26.10 (GND), U27.8 (GND), U28.6 (A4), U28.7 (A5), U28.8 (A6), U28.9 (A7), U28.10 (GND), U29.10 (GND), U30.5 (DP), U31.10 (GND), U31.13 (D4), U31.14 (D5), U31.17 (D6), U31.18 (D7), U32.5 (DP), U34.7 (GND), U35.1 (GND), U36.8 (GND), U36.13 (A1), U36.14 (A0), U36.15 (E), U37.8 (GND), U38.4 (E1), U38.5 (E2), U38.8 (GND), U39.7 (GND), U40.7 (GND), U41.7 (GND), U42.7 (D2), U42.8 (D3), U42.10 (GND), U42.13 (D4), U42.14 (D5), U42.17 (D6), U42.18 (D7), U43.7 (GND), U44.5 (DP)
unnamed: C8.2, R26.1, U20.1
unnamed: D1.2 (A), R7.1
unnamed: D1.1 (K), SW7.1 (A)
unnamed: D2.2 (A), R27.2
unnamed: D3.2 (A), R13.1
unnamed: D7.2 (A), R12.1
unnamed: D8.2 (A), R28.2
unnamed: D9.2 (A), R29.2
unnamed: D10.2 (A), R30.2
unnamed: D24.2 (A), R47.1
unnamed: D25.2 (A), R48.1
unnamed: D26.2 (A), R49.1
unnamed: D27.2 (A), R50.1
unnamed: D28.2 (A), R51.1
unnamed: D29.2 (A), R52.1
unnamed: D30.2 (A), R53.1
unnamed: D31.2 (A), R54.1
unnamed: D32.2 (A), R55.1
unnamed: D33.2 (A), R56.1
unnamed: D34.2 (A), R57.1
unnamed: D35.2 (A), R58.1
unnamed: D36.2 (A), R59.1
unnamed: D37.2 (A), R60.1
unnamed: D38.2 (A), R61.1
unnamed: D39.2 (A), R62.1
unnamed: D40.2 (A), R63.1
unnamed: D41.2 (A), R64.1
unnamed: D42.2 (A), R65.1
unnamed: D43.2 (A), R66.1
unnamed: D44.2 (A), R67.1
unnamed: D45.2 (A), R68.1
unnamed: D46.2 (A), R69.1
unnamed: D47.2 (A), R70.1
unnamed: D48.2 (A), R71.1
unnamed: D49.2 (A), R72.1
unnamed: D50.2 (A), R73.1
unnamed: D51.2 (A), R74.1
unnamed: D52.2 (A), R75.1
unnamed: D53.2 (A), R76.1
unnamed: D54.2 (A), R77.1
unnamed: D55.2 (A), R86.1
unnamed: D56.2 (A), R87.1
unnamed: D57.2 (A), R88.1
unnamed: D58.2 (A), R89.1
unnamed: D59.2 (A), R90.1
unnamed: D60.2 (A), R91.1
unnamed: D61.2 (A), R92.1
unnamed: D62.2 (A), R93.1
unnamed: D63.2 (A), R94.2
unnamed: D64.2 (A), R95.2
unnamed: D65.2 (A), R96.2
unnamed: D66.2 (A), R97.2
unnamed: D67.2 (A), R98.2
unnamed: D68.2 (A), R99.2
unnamed: D69.2 (A), R100.2
unnamed: D70.2 (A), R101.2
unnamed: D71.2 (A), R102.2
unnamed: D72.2 (A), R103.2
unnamed: D73.2 (A), R104.2
unnamed: D74.2 (A), R105.2
unnamed: D75.2 (A), R106.2
unnamed: D76.2 (A), R107.2
unnamed: D77.2 (A), R108.2
unnamed: D78.2 (A), R109.2
unnamed: D79.2 (A), R110.2
unnamed: D80.2 (A), R111.1
unnamed: D81.2 (A), R112.1
unnamed: D82.2 (A), R113.1
unnamed: IC1.10 (A0), U29.2 (Q0)
unnamed: IC1.9 (A1), U29.5 (Q1)
unnamed: IC1.8 (A2), U29.6 (Q2)
unnamed: IC1.7 (A3), U29.9 (Q3)
unnamed: IC1.6 (A4), U29.12 (Q4)
unnamed: IC1.5 (A5), U29.15 (Q5)
unnamed: IC1.4 (A6), U29.16 (Q6)
unnamed: IC1.3 (A7), U29.19 (Q7)
unnamed: IC1.25 (A8), U34.2 (~Q), U34.9 (C), U36.2 (A0)
unnamed: IC1.24 (A9), U34.6 (~Q), U36.3 (A1)
unnamed: IC1.21 (A10), SW6.5 (B)
unnamed: R23.2, SW5.2, U43.12, U43.13
unnamed: C3.2, U1.5 (CV)
unnamed: R1.2, R2.1, RV1.2, U1.7 (DIS)
unnamed: U1.3 (Q), U3.1
unnamed: C4.1, R1.1, RV1.3, U1.2 (TR), U1.6 (THR)
unnamed: U3.3, U6.1
unnamed: U3.4, U3.8
unnamed: U3.6, U6.2
unnamed: U3.11, U6.5
unnamed: C6.1, U4.5 (CV)
unnamed: C5.1, R4.1, U4.6 (THR), U4.7 (DIS)
unnamed: U3.5, U4.3 (Q)
unnamed: R3.2, SW1.2, U4.2 (TR)
unnamed: C7.1, U5.5 (CV)
unnamed: U3.2, U3.9, U3.10, U5.3 (Q)
unnamed: R6.2, SW8.3 (C), U5.4 (R)
unnamed: R5.2, SW8.1 (A), U5.2 (TR)
unnamed: U6.3, U6.4
unnamed: U9.6 (B1), U12.11
unnamed: U9.2 (B2), U12.8
unnamed: U9.15 (B3), U12.6
unnamed: U9.11 (B4), U12.3
unnamed: U10.6 (B1), U13.3
unnamed: U10.2 (B2), U13.6
unnamed: U10.15 (B3), U13.8
unnamed: U10.11 (B4), U13.11
unnamed: U9.9 (C4), U10.7 (C0)
unnamed: U10.9 (C4), U42.3 (D0)
unnamed: U14.2 (A0), U17.4 (Qa)
unnamed: U14.3 (A1), U17.7 (Qb)
unnamed: U14.4 (A2), U17.12 (Qc)
unnamed: U14.5 (A3), U17.9 (Qd)
unnamed: U14.6 (A4), U18.4 (Qa)
unnamed: U14.7 (A5), U18.7 (Qb)
unnamed: U14.8 (A6), U18.12 (Qc)
unnamed: U14.9 (A7), U18.9 (Qd)
unnamed: U15.27 (~WE), U20.6
unnamed: R25.1, SW4.2, U19.2 (I0a)
unnamed: U19.3 (I1a), U20.3
unnamed: R8.1, SW2.5, U21.2 (I0a)
unnamed: R9.1, SW2.6, U21.5 (I0b)
unnamed: R10.1, SW2.7, U21.14 (I0c)
unnamed: R11.1, SW2.8, U21.11 (I0d)
unnamed: U21.3 (I1a), U31.2 (Q0)
unnamed: U21.6 (I1b), U31.5 (Q1)
unnamed: U21.13 (I1c), U31.6 (Q2)
unnamed: U21.10 (I1d), U31.9 (Q3)
unnamed: U34.12 (C), U35.3 (Q)
unnamed: C10.2, U35.5 (CV)
unnamed: R21.2, R22.1, U35.7 (DIS)
unnamed: C9.1, R21.1, U35.2 (TR), U35.6 (THR)
unnamed: U36.4 (O0), U44.3 (CC), U44.8 (CC)
unnamed: U22.3 (CC), U22.8 (CC), U36.5 (O1)
unnamed: U30.3 (CC), U30.8 (CC), U36.6 (O2)
unnamed: U32.3 (CC), U32.8 (CC), U36.7 (O3)
unnamed: U37.1 (~MR), U43.6
unnamed: U38.10 (O5), U43.2
unnamed: U8.1, U39.1
unnamed: U8.4, U39.2
unnamed: U39.3, U39.9
unnamed: U8.10, U39.4
unnamed: U8.13, U39.5
unnamed: U39.6, U39.10
unnamed: U39.8, U42.4 (D1)
unnamed: U43.3, U43.4, U43.5

Notes on the sheet:
Program Counter
Control Word LEDs
EEPROM Driven LCD Display
This is the LCD Display Module. It uses an EEPROM. We should either use DIP and remove from board to program/solder after programming or design such that it can be programmed while still in the board.
Control Logic
Special Note (for Dominic) the input pins are only enabled when J is pulled low, so we are fine connecting them directly to the bus.
Clock module
Write to RAM MUX to switch between manual and automatic operation, with a switch for manual operation and an edge detect for automatic operation.
Instruction Register
Instruction Clock
This stage debounces the button that selects between automated clock pulse and manually advanced clock pulses.
Power Module. See about using an iron bead.
RAM chip, with multiplexers and tri-state buffers
ALU, and A and B registers
Lights!
Register B
XOR Gates, for subtract functionality
This stage automatically generates a pulse
Register A
Memory Address
ALU
Memory Contents
This stage debounces the switch that manually advances the clock.
Control Logic Instruction Bit 1
Toggle RAM Mode
Instruction Clock DEC Output
Binary Adders
Bus
Registers
Logic Power and Extras

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
