Davoskio/8-bit-computer/8-Bit-Computer/8-Bit-Computer.kicad_pcb

## KiCad design 8-Bit-Computer/8-Bit-Computer.kicad_pcb (continued)

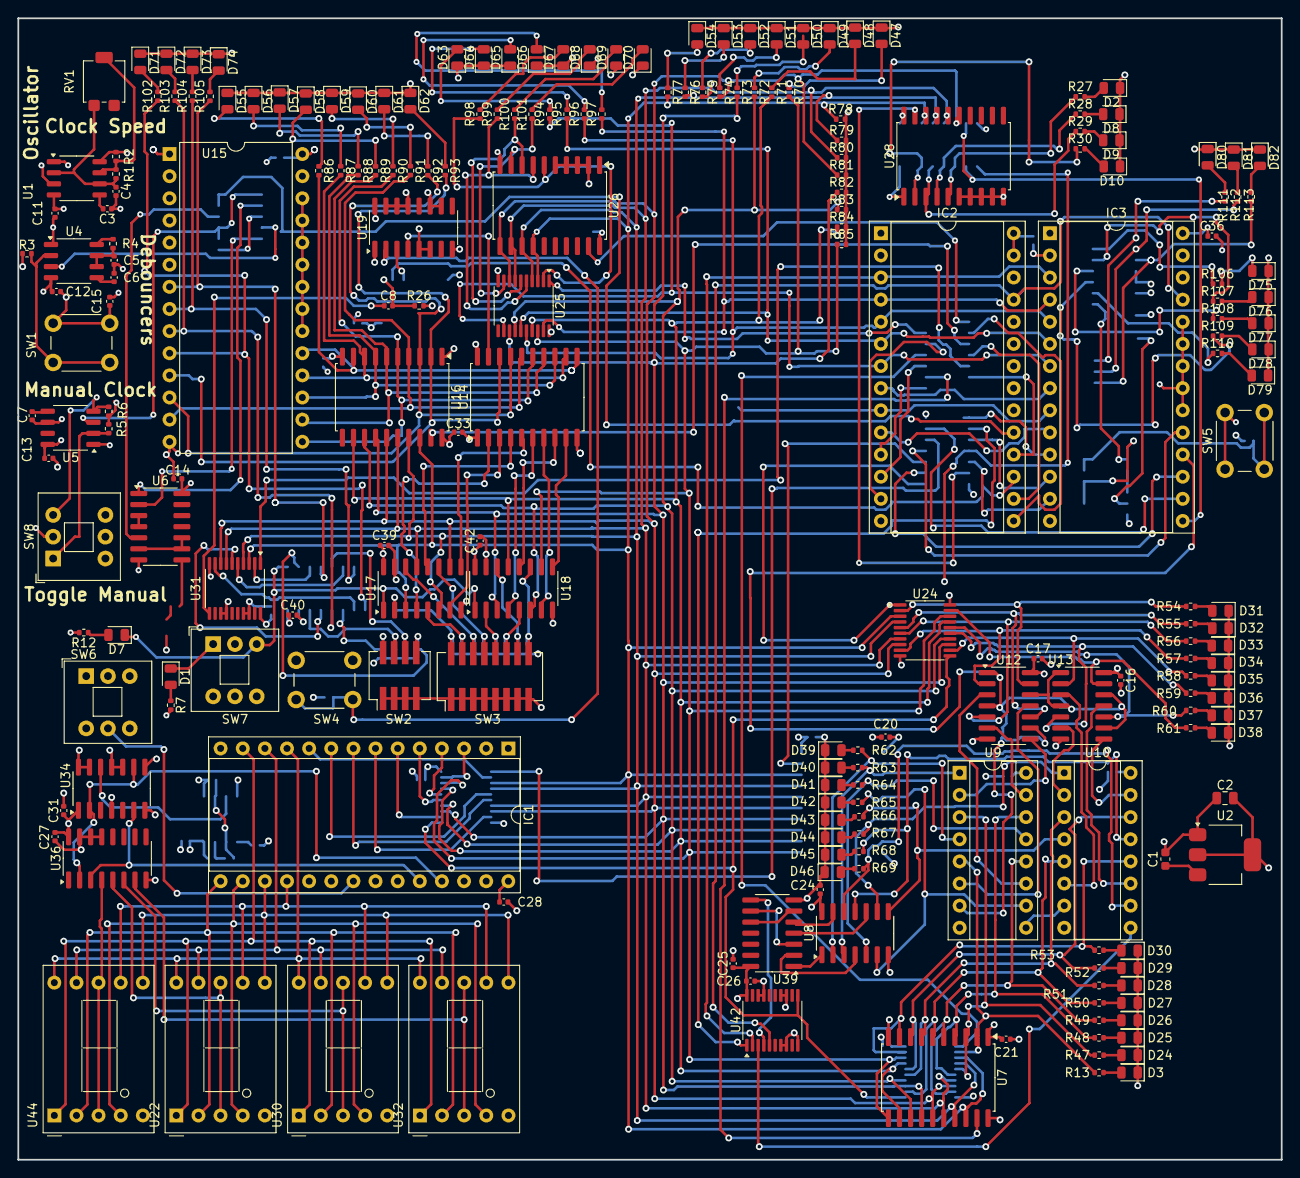
[picture p9: board 8-Bit-Computer.kicad_pcb from above]

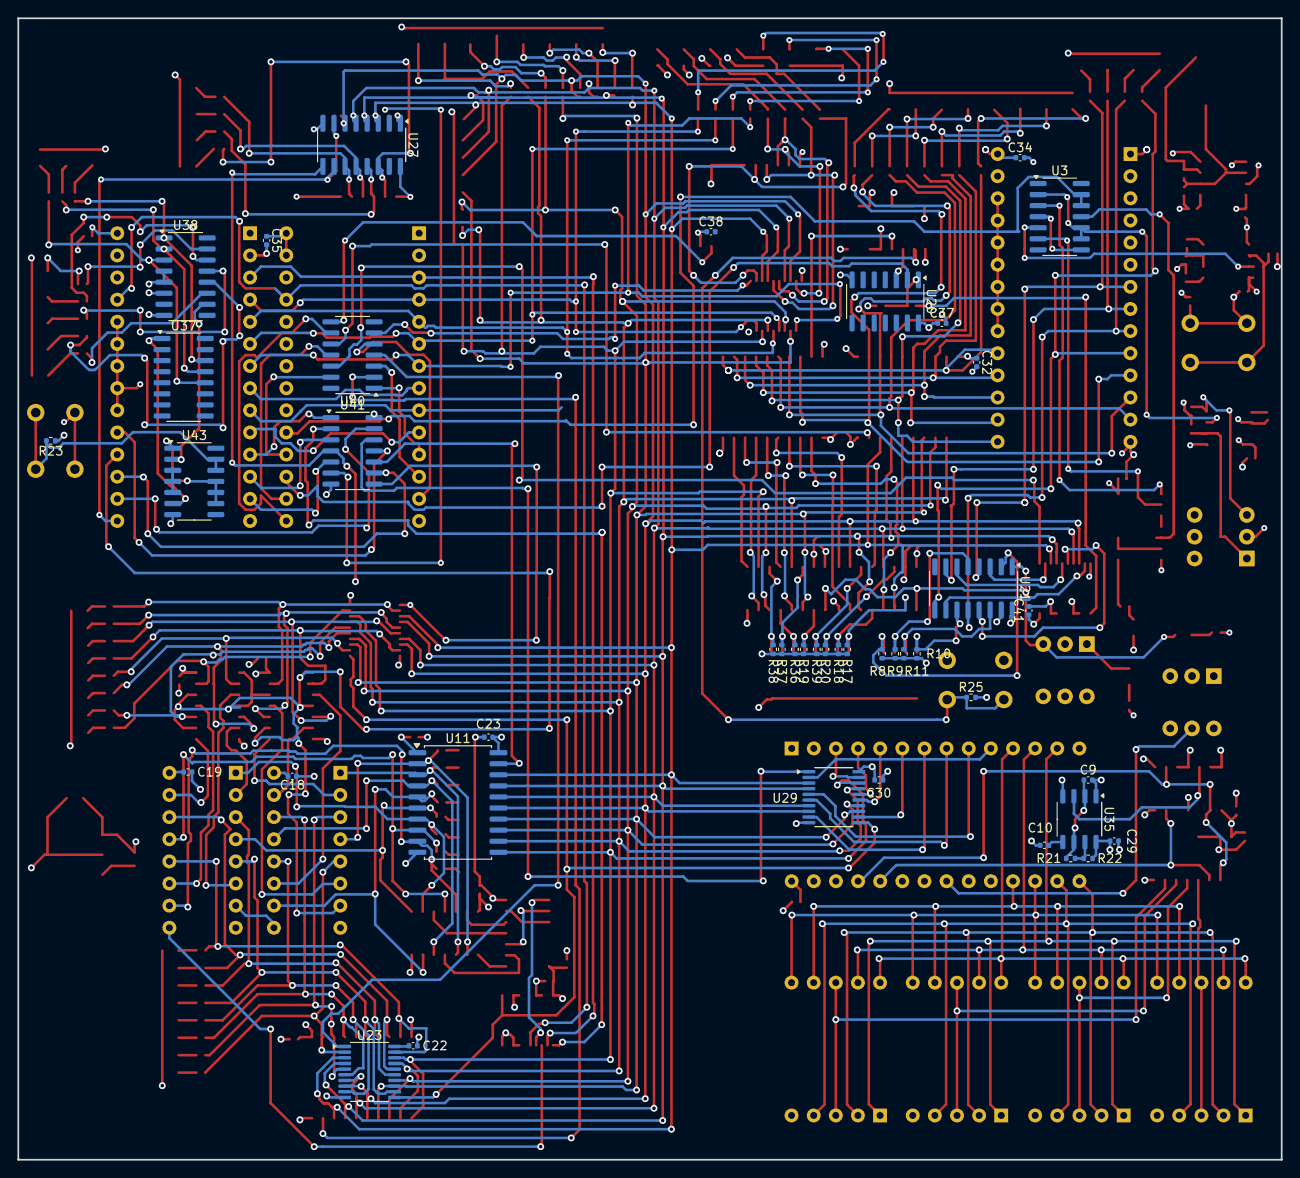
[picture p10: board 8-Bit-Computer.kicad_pcb from below]

Board: 4 copper layers, 145.0 x 131.0 mm, 260 parts (43 on the bottom side), 261 nets.
