Davoskio/8-bit-computer/(commit log)

2023-12-29 Added KiCAD project for 8 bit computer
    [8-Bit-Computer.kicad_pcb, 8-Bit-Computer.kicad_sch]
2023-12-29 finished monostable
    [8-Bit-Computer.kicad_sch]
2023-12-30 finished clock module
    [8-Bit-Computer.kicad_sch]
2023-12-30 working on alu
    [8-Bit-Computer.kicad_sch]
2023-12-31 ALU done
    [8-Bit-Computer.kicad_sch]
2024-01-02 not done much
    [8-Bit-Computer.kicad_sch]
2024-01-03 still working on mem
    [8-Bit-Computer.kicad_sch]
2024-01-04 working on mem
    [8-Bit-Computer.kicad_sch]
2024-01-04 mem done. will review tomorrow.
    [8-Bit-Computer.kicad_sch]
2024-01-04 changed register chips to 74ls377
    [8-Bit-Computer.kicad_sch]
2024-01-04 will be back at it
    [8-Bit-Computer.kicad_sch]
2024-04-04 will add eeprom schematic
2024-04-06 added eeprom and 7-seg display
    [8-Bit-Computer.kicad_sch]
2024-04-17 Cleaned up Current Schematics
    [8-Bit-Computer.kicad_sch]
2024-04-19 Cleaned up RAM module
    [8-Bit-Computer.kicad_sch]
2024-04-20 completed ALU and most of the control logic
    [8-Bit-Computer.kicad_sch]
2024-04-20 Completed Schematics Version 1
    [8-Bit-Computer.kicad_sch]
2024-04-21 Finished adding footprints
    [8-Bit-Computer.kicad_pcb, 8-Bit-Computer.kicad_sch]
2024-04-22 finished the PCB layout for ALU and clock
    [8-Bit-Computer.kicad_pcb, 8-Bit-Computer.kicad_sch]
2024-04-22 completed display
    [8-Bit-Computer.kicad_pcb, 8-Bit-Computer.kicad_sch]
2024-04-25 Finished Ram and started control logic
    [8-Bit-Computer.kicad_pcb, 8-Bit-Computer.kicad_sch]
2024-04-28 remaining to fit in clock
    [8-Bit-Computer.kicad_pcb]
2024-04-30 need to place leds
    [8-Bit-Computer.kicad_pcb]
2024-05-02 done with all LEDs except control word
    [8-Bit-Computer.kicad_pcb]
2024-05-03 fixing errors
    [8-Bit-Computer.kicad_pcb]
2024-05-07 removed control word LEDs
    [8-Bit-Computer.kicad_pcb, 8-Bit-Computer.kicad_sch]
2024-05-28 Created Gerber Files
    [8-Bit-Computer-B_Cu.gbl, 8-Bit-Computer-B_Mask.gbs, 8-Bit-Computer-B_Paste.gbp, 8-Bit-Computer-B_Silkscreen.gbo, 8-Bit-Computer-Edge_Cuts.gm1, 8-Bit-Computer-F_Cu.gtl, 8-Bit-Computer-F_Mask.gts, 8-Bit-Computer-F_Paste.gtp]
2024-05-30 added R and C values
    [8-Bit-Computer.kicad_sch]
2024-06-01 changed some capacitors and resistors to top side
    [8-Bit-Computer-B_Cu.gbl, 8-Bit-Computer-B_Mask.gbs, 8-Bit-Computer-B_Paste.gbp, 8-Bit-Computer-B_Silkscreen.gbo, 8-Bit-Computer-Edge_Cuts.gm1, 8-Bit-Computer-F_Cu.gtl, 8-Bit-Computer-F_Mask.gts, 8-Bit-Computer-F_Paste.gtp]
2024-11-25 schematic and PCB pics
